mgriff2000/OmniAnt/README.md

# OmniAnt
Repo for the KiCad project for OmniAnt
