mgriff2000/OmniAnt/OmniAnt/report.txt

Info: Processing symbol 'AC1:Footprints:LIS3DHTR'.
Info: Processing symbol 'AC2:Footprints:LIS3DHTR'.
Info: Processing symbol 'C1:PCM_JLCPCB:C_0805'.
Info: Processing symbol 'C2:PCM_JLCPCB:C_0603'.
Info: Processing symbol 'C3:PCM_JLCPCB:C_0603'.
Info: Processing symbol 'C4:PCM_JLCPCB:C_0603'.
Info: Processing symbol 'C5:PCM_JLCPCB:C_0603'.
Info: Processing symbol 'C6:PCM_JLCPCB:C_0805'.
Info: Processing symbol 'C7:PCM_JLCPCB:C_0805'.
Info: Processing symbol 'C8:PCM_JLCPCB:C_0603'.
Info: Processing symbol 'C9:PCM_JLCPCB:C_0805'.
Info: Processing symbol 'C10:PCM_JLCPCB:C_0805'.
Info: Processing symbol 'C11:PCM_JLCPCB:C_0603'.
Info: Processing symbol 'C12:PCM_JLCPCB:C_0805'.
Info: Processing symbol 'C13:PCM_JLCPCB:C_0805'.
Info: Processing symbol 'C14:PCM_JLCPCB:C_0805'.
Info: Processing symbol 'C15:PCM_JLCPCB:C_0603'.
Info: Processing symbol 'C16:PCM_JLCPCB:C_0603'.
Info: Processing symbol 'C17:PCM_JLCPCB:C_0603'.
Info: Processing symbol 'C18:PCM_JLCPCB:C_0603'.
Info: Processing symbol 'C19:PCM_JLCPCB:C_0805'.
Info: Processing symbol 'C20:PCM_JLCPCB:C_0603'.
Info: Processing symbol 'C21:PCM_JLCPCB:C_0603'.
Info: Processing symbol 'C22:PCM_JLCPCB:C_0603'.
Info: Processing symbol 'C23:PCM_JLCPCB:C_0603'.
Info: Processing symbol 'C24:PCM_JLCPCB:C_0603'.
Info: Processing symbol 'C25:PCM_JLCPCB:C_0603'.
Info: Processing symbol 'C26:PCM_JLCPCB:C_0603'.
Info: Processing symbol 'C27:PCM_JLCPCB:C_0603'.
Info: Processing symbol 'C28:PCM_JLCPCB:C_0603'.
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
Change Q2 footprint from 'Footprints:NVMFS5C442NLWFAFT1G' to 'NVMFS5C442NLWFAFT1G'.
Change Q4 footprint from 'Footprints:NVMFS5C442NLWFAFT1G' to 'NVMFS5C442NLWFAFT1G'.
Change Q11 footprint from 'Footprints:NVMFS5C442NLWFAFT1G' to 'NVMFS5C442NLWFAFT1G'.

Warning: No net found for component J8 pad S2 (no pin S2 in symbol).
Warning: No net found for component J9 pad S1 (no pin S1 in symbol).
Warning: No net found for component J9 pad S2 (no pin S2 in symbol).
Warning: No net found for component U3 pad 44 (no pin 44 in symbol).
Warning: No net found for component U3 pad 41 (no pin 41 in symbol).
Warning: No net found for component U3 pad 45 (no pin 45 in symbol).
Warning: No net found for component U3 pad 39 (no pin 39 in symbol).
Warning: No net found for component U3 pad 42 (no pin 42 in symbol).
Warning: No net found for component U3 pad 38 (no pin 38 in symbol).
Warning: No net found for component J6 pad S1 (no pin S1 in symbol).
Warning: No net found for component U3 pad 43 (no pin 43 in symbol).
Warning: No net found for component J6 pad S2 (no pin S2 in symbol).
Warning: No net found for component J7 pad S1 (no pin S1 in symbol).
Warning: No net found for component U5 pad 45 (no pin 45 in symbol).
Warning: No net found for component U5 pad 44 (no pin 44 in symbol).
Warning: No net found for component U5 pad 41 (no pin 41 in symbol).
Warning: No net found for component U5 pad 39 (no pin 39 in symbol).
Warning: No net found for component U5 pad 42 (no pin 42 in symbol).
Warning: No net found for component U5 pad 38 (no pin 38 in symbol).
Warning: No net found for component U5 pad 43 (no pin 43 in symbol).
Warning: No net found for component U5 pad 40 (no pin 40 in symbol).
Warning: No net found for component J7 pad S2 (no pin S2 in symbol).
Warning: No net found for component J8 pad S1 (no pin S1 in symbol).
Warning: No net found for component U3 pad 40 (no pin 40 in symbol).

Info: Total warnings: 24, errors: 0.
