mgriff2000/OmniAnt/OmniAnt/OmniAnt.kicad_pcb

## KiCad design OmniAnt/OmniAnt.kicad_pcb (2025-11-13)

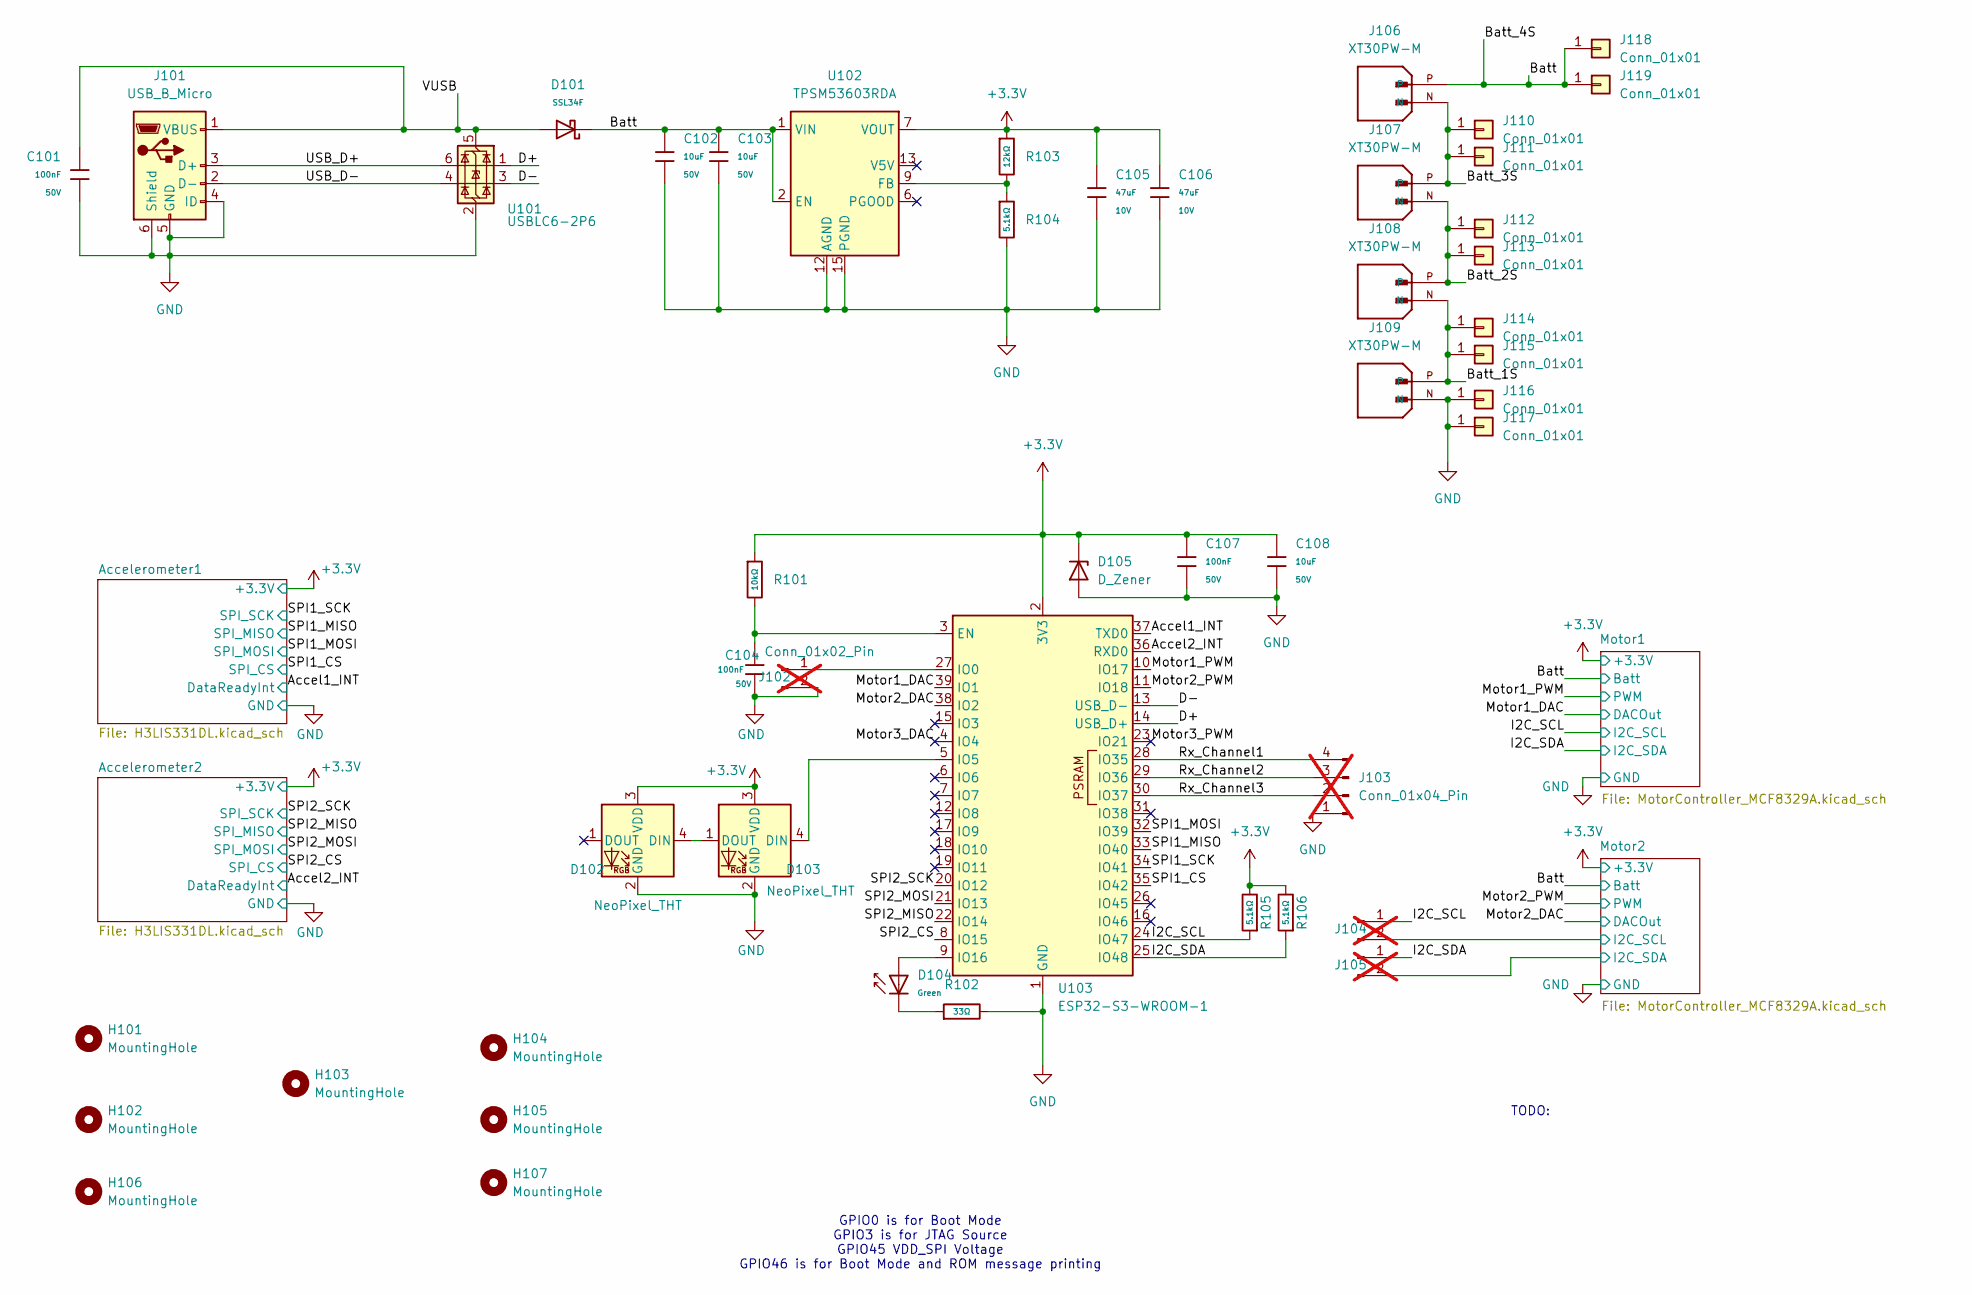
[picture p1: schematic OmniAnt.kicad_sch]

Parts:
C101, C104, C107: 100nF; C_0603; Voltage Rated 50V; Tolerance ±10%; Part CC0603KRX7R9BB104; LCSC C14663
C102, C103, C108: 10uF; C_0805; Voltage Rated 50V; Tolerance ±10%; Part GRM21BR61H106KE43L; LCSC C440198
C105, C106: 47uF; C_1206; Voltage Rated 10V; Tolerance ±20%; Part CL31A476MPHNNNE; LCSC C96123
D101: SSL34F; D_SMAF; Part SSL34F; LCSC C28646282
D102, D103: NeoPixel_THT; LED_D5.0mm-4_RGB
D104: Green; D_0805; Part KT-0805G; LCSC C2297
D105: D_Zener; D_SOD-123FL; Manufacturer Part Number SMF3.3; LCSC C2649858
H101, H102, H104, H105, H106, H107: MountingHole; MountingHole_3mm
H103: MountingHole; MountingHole_4.3mm_M4_DIN965
J101: USB_B_Micro; USB_Micro-B_Molex-105017-0001; LCSC C136000
J102, J104, J105: Conn_01x02_Pin; PinHeader_1x02_P1.27mm_Vertical; not fitted
J103: Conn_01x04_Pin; PinHeader_1x04_P2.54mm_Vertical; not fitted
J106, J107, J108, J109: XT30PW-M; AMASS_XT30PW-M; PARTREV 1.2; LCSC C431092
J110, J111, J112, J113, J114, J115, J116, J117, J118, J119: Conn_01x01; SolderWire-1.5sqmm_1x01_D1.7mm_OD3mm
R101: 10kΩ; R_0402; Overload Voltage (Max) 50V; Tolerance ±1%; Part 0402WGF1002TCE; LCSC C25744
R102: 33Ω; R_0402; Overload Voltage (Max) 50V; Tolerance ±1%; Part 0402WGF330JTCE; LCSC C25105
R103: 12kΩ; R_0402; Overload Voltage (Max) 50V; Tolerance ±1%; Part 0402WGF1202TCE; LCSC C25752
R104, R105, R106: 5.1kΩ; R_0402; Overload Voltage (Max) 50V; Tolerance ±1%; Part 0402WGF5101TCE; LCSC C25905
U101: USBLC6-2P6; SOT-666; LCSC C15999
U102: TPSM53603RDA; Texas_B3QFN-14-1EP_5x5.5mm_P0.65mm_ThermalVia; LCSC C2860943
U103: ESP32-S3-WROOM-1; LCSC C2913197

Connections:
+3.3V: C105.1, C106.1, C107.1, C108.1, D102.3 (VDD), D103.3 (VDD), D105.1 (K), R101.1, R103.1, R105.2, R106.2, U102.7 (VOUT), U102.8 (VOUT), U103.2 (3V3); also elsewhere on the board
/Accel1_INT: U103.37 (TXD0); also elsewhere on the board
/Accel2_INT: U103.36 (RXD0); also elsewhere on the board
/Batt: C102.1, C103.1, D101.1, J106.P, J118.1, J119.1, U102.1 (VIN), U102.2 (EN), U102.14 (VIN); also elsewhere on the board
/Batt_1S: J108.N, J109.P, J114.1, J115.1
/Batt_2S: J107.N, J108.P, J112.1, J113.1
/Batt_3S: J106.N, J107.P, J110.1, J111.1
/D+: U101.1 (I/O1), U103.14 (USB_D+)
/D-: U101.3 (I/O2), U103.13 (USB_D-)
/I2C_SCL: J104.1, R105.1, U103.24 (IO47); also elsewhere on the board
/I2C_SDA: J105.1, R106.1, U103.25 (IO48); also elsewhere on the board
/Motor1_DAC: U103.39 (IO1); also elsewhere on the board
/Motor1_PWM: U103.10 (IO17); also elsewhere on the board
/Motor2/I2C_SCL: J104.2; also elsewhere on the board
/Motor2/I2C_SDA: J105.2; also elsewhere on the board
/Motor2_DAC: U103.38 (IO2); also elsewhere on the board
/Motor2_PWM: U103.11 (IO18); also elsewhere on the board
/Motor3_DAC: U103.4 (IO4)
/Motor3_PWM: U103.23 (IO21)
/Rx_Channel1: J103.4, U103.28 (IO35)
/Rx_Channel2: J103.3, U103.29 (IO36)
/Rx_Channel3: J103.2, U103.30 (IO37)
/SPI1_CS: U103.35 (IO42); also elsewhere on the board
/SPI1_MISO: U103.33 (IO40); also elsewhere on the board
/SPI1_MOSI: U103.32 (IO39); also elsewhere on the board
/SPI1_SCK: U103.34 (IO41); also elsewhere on the board
/SPI2_CS: U103.8 (IO15); also elsewhere on the board
/SPI2_MISO: U103.22 (IO14); also elsewhere on the board
/SPI2_MOSI: U103.21 (IO13); also elsewhere on the board
/SPI2_SCK: U103.20 (IO12); also elsewhere on the board
/USB_D+: J101.3 (D+), U101.6 (I/O1)
/USB_D-: J101.2 (D-), U101.4 (I/O2)
/VUSB: C101.1, D101.2, J101.1 (VBUS), U101.5 (VBUS)
GND: C101.2, C102.2, C103.2, C104.2, C105.2, C106.2, C107.2, C108.2, D102.2 (GND), D103.2 (GND), D105.2 (A), J101.4 (ID), J101.5 (GND), J101.6 (Shield), J102.2, J103.1, J109.N, J116.1, J117.1, R102.2, R104.2, U101.2 (GND), U102.3 (PGND), U102.10 (PGND), U102.11 (PGND), U102.12 (AGND), U102.15 (PGND), U103.1 (GND), U103.40 (GND), U103.41 (GND); also elsewhere on the board
unnamed: D102.4 (DIN), D103.1 (DOUT)
unnamed: D103.4 (DIN), U103.5 (IO5)
unnamed: D104.1, R102.1
unnamed: J102.1, U103.27 (IO0)
unnamed: R103.2, R104.1, U102.9 (FB)
unnamed: C104.1, R101.2, U103.3 (EN)
unnamed: D104.2, U103.9 (IO16)

Notes on the sheet:
TODO:
GPIO0 is for Boot Mode GPIO3 is for JTAG Source GPIO45 VDD_SPI Voltage GPIO46 is for Boot Mode and ROM message printing

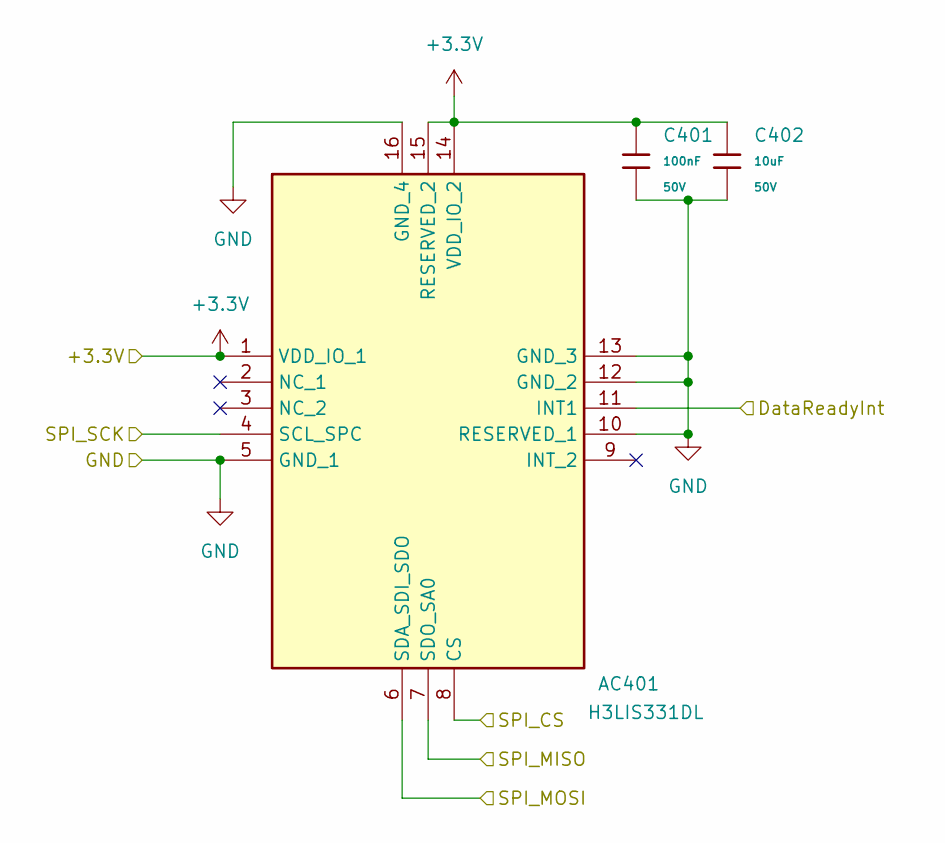
[picture p2: schematic H3LIS331DL.kicad_sch]

Parts:
AC401: H3LIS331DL; LIS3DHTR; Manufacturer_Part_Number H3LIS331DL; Mouser Part Number 511-H3LIS331DL
C401: 100nF; C_0603; Voltage Rated 50V; Tolerance ±10%; Part CC0603KRX7R9BB104; LCSC C14663
C402: 10uF; C_0805; Voltage Rated 50V; Tolerance ±10%; Part GRM21BR61H106KE43L; LCSC C440198

Connections:
+3.3V: AC401.1 (VDD_IO_1), AC401.14 (VDD_IO_2), AC401.15 (RESERVED_2), C401.1, C402.1; also elsewhere on the board
/Accel1_INT: AC401.11 (INT1); also elsewhere on the board
/SPI1_CS: AC401.8 (CS); also elsewhere on the board
/SPI1_MISO: AC401.7 (SDO_SA0); also elsewhere on the board
/SPI1_MOSI: AC401.6 (SDA_SDI_SDO); also elsewhere on the board
/SPI1_SCK: AC401.4 (SCL_SPC); also elsewhere on the board
GND: AC401.5 (GND_1), AC401.10 (RESERVED_1), AC401.12 (GND_2), AC401.13 (GND_3), AC401.16 (GND_4), C401.2, C402.2; also elsewhere on the board

Parts of its further copies:
AC501: H3LIS331DL; LIS3DHTR; Manufacturer_Part_Number H3LIS331DL; Mouser Part Number 511-H3LIS331DL
C501: 100nF; C_0603; Voltage Rated 50V; Tolerance ±10%; Part CC0603KRX7R9BB104; LCSC C14663
C502: 10uF; C_0805; Voltage Rated 50V; Tolerance ±10%; Part GRM21BR61H106KE43L; LCSC C440198

Connections of its further copies:
+3.3V: AC501.1 (VDD_IO_1), AC501.14 (VDD_IO_2), AC501.15 (RESERVED_2), C501.1, C502.1; also elsewhere on the board
/Accel2_INT: AC501.11 (INT1); also elsewhere on the board
/SPI2_CS: AC501.8 (CS); also elsewhere on the board
/SPI2_MISO: AC501.7 (SDO_SA0); also elsewhere on the board
/SPI2_MOSI: AC501.6 (SDA_SDI_SDO); also elsewhere on the board
/SPI2_SCK: AC501.4 (SCL_SPC); also elsewhere on the board
GND: AC501.5 (GND_1), AC501.10 (RESERVED_1), AC501.12 (GND_2), AC501.13 (GND_3), AC501.16 (GND_4), C501.2, C502.2; also elsewhere on the board

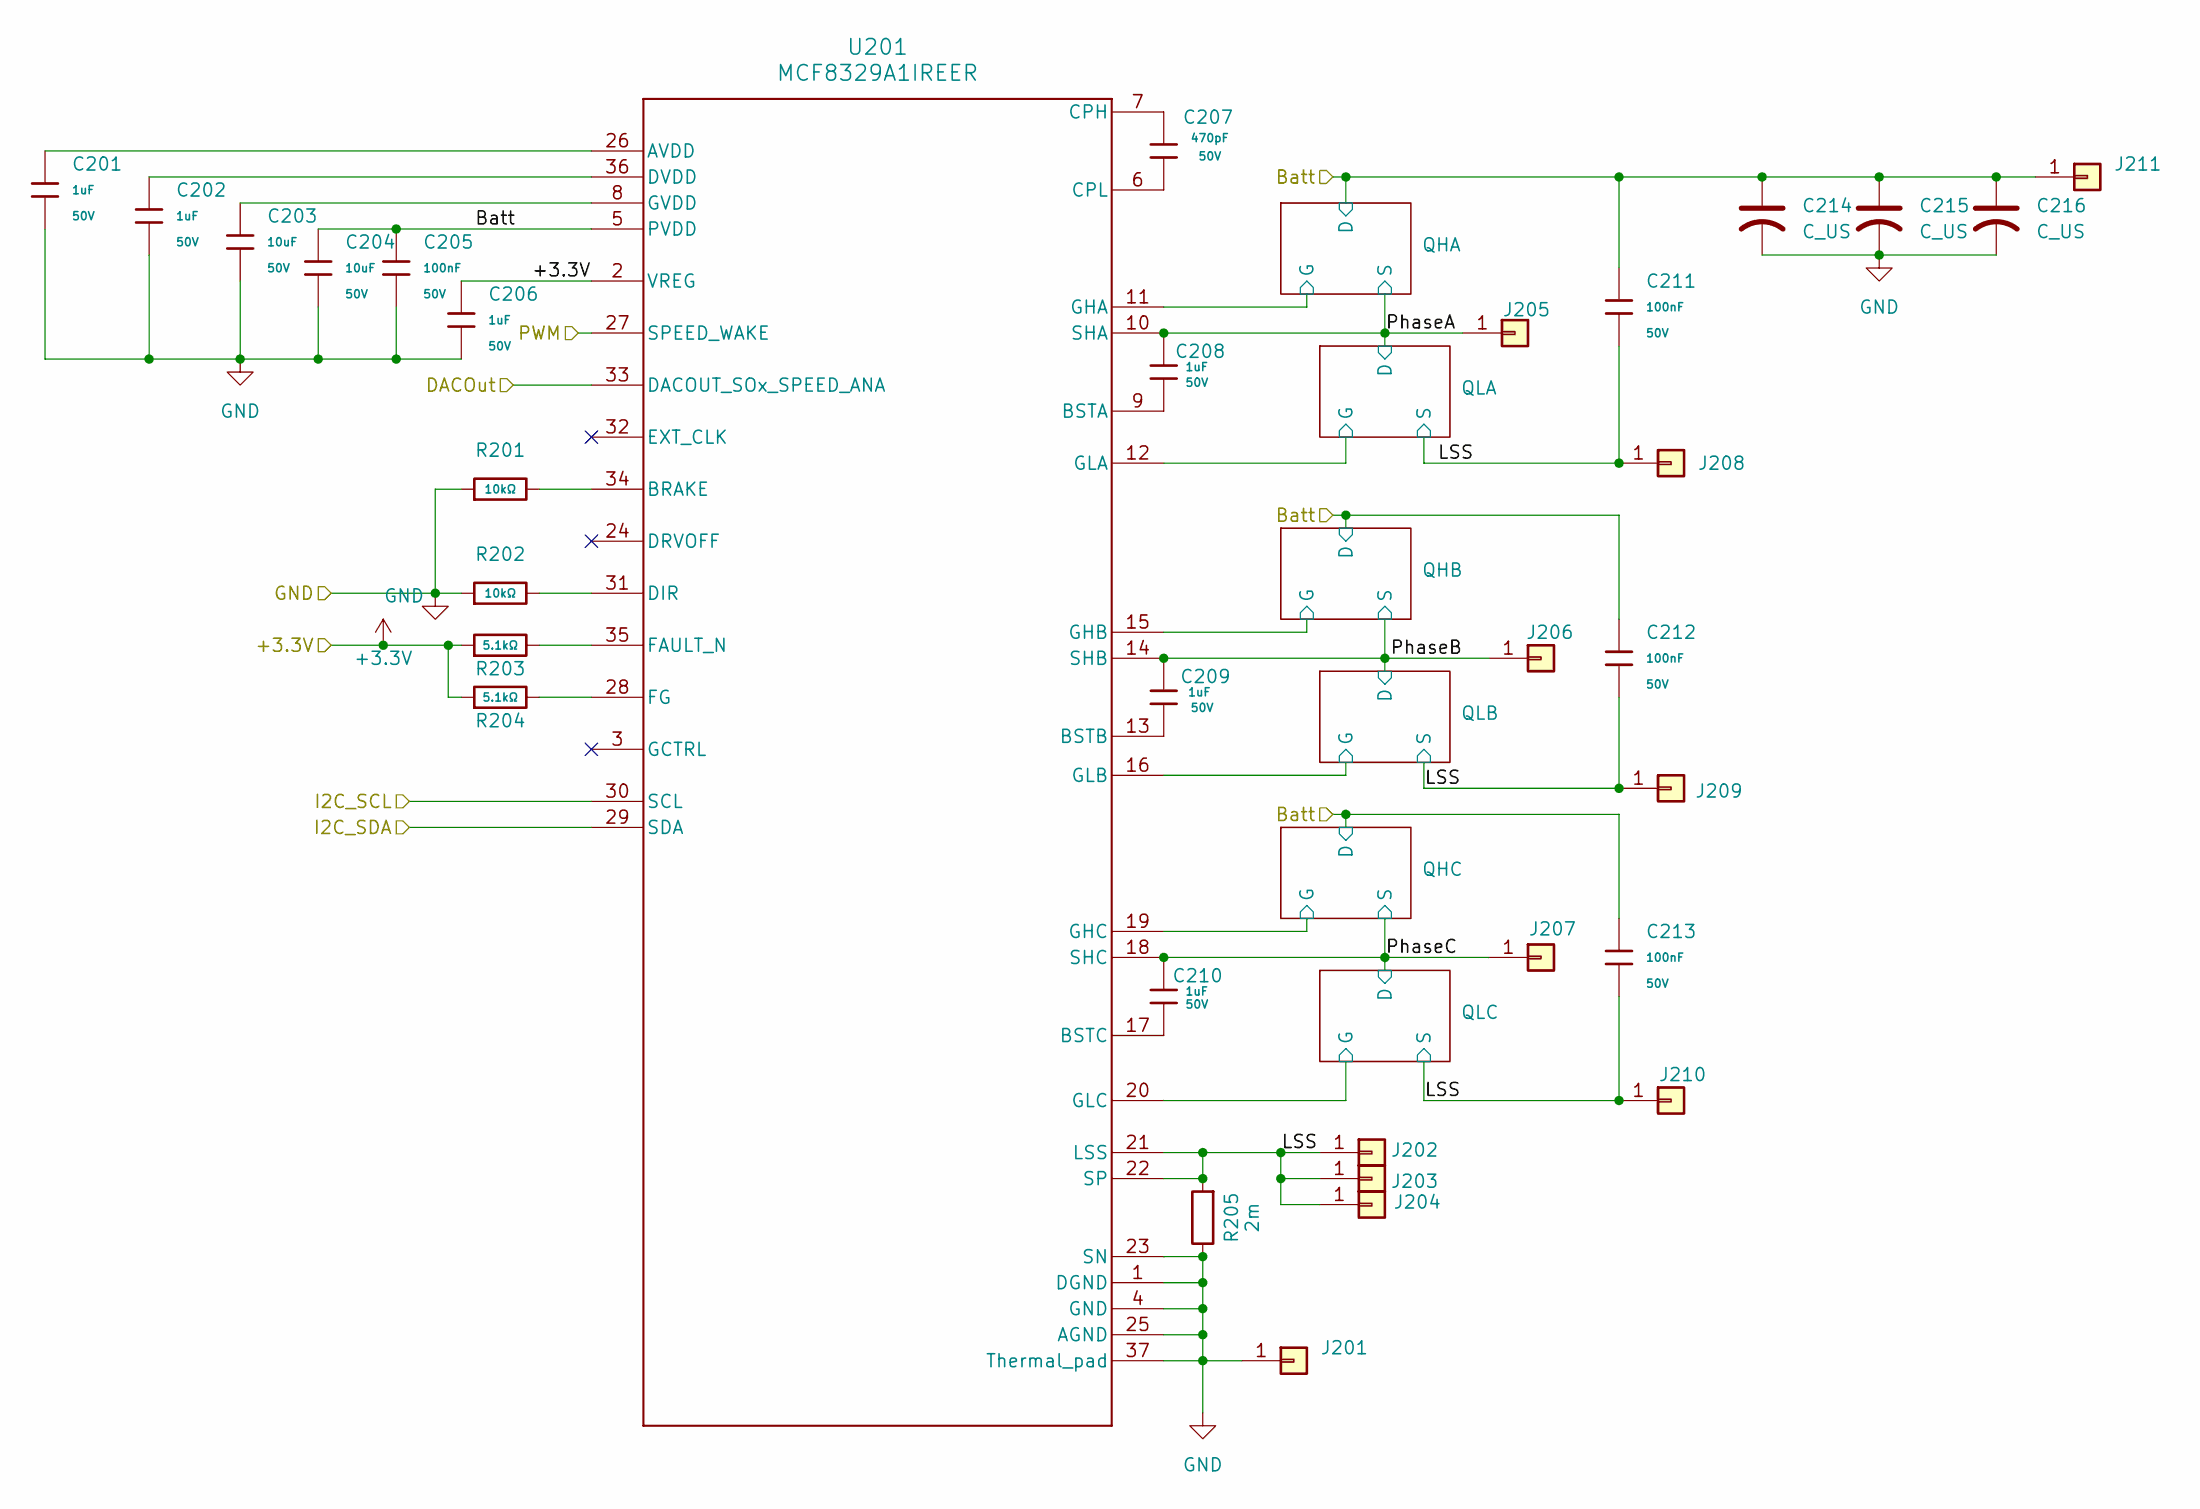
[picture p3: schematic MotorController_MCF8329A.kicad_sch]

Parts:
C201, C202, C206, C208, C209, C210: 1uF; C_0603; Voltage Rated 50V; Tolerance ±10%; Part CL10A105KB8NNNC; LCSC C15849
C203, C204: 10uF; C_0805; Voltage Rated 50V; Tolerance ±10%; Part GRM21BR61H106KE43L; LCSC C440198
C205, C211, C212, C213: 100nF; C_0603; Voltage Rated 50V; Tolerance ±10%; Part CC0603KRX7R9BB104; LCSC C14663
C207: 470pF; C_0603; Voltage Rated 50V; Tolerance ±10%; Part 0603B471K500NT; LCSC C1620
C214: C_US; CP_Radial_D6.3mm_P2.50mm; Manufacturer Part Number HT1E227M0607PC
C215, C216: C_US; CP_Radial_D6.3mm_P2.50mm
J201, J211: Conn_01x01; SolderWire-1.5sqmm_1x01_D1.7mm_OD3mm
J202, J203, J204, J205, J206, J207, J208, J209, J210: Conn_01x01; SolderWire-0.25sqmm_1x01_D0.65mm_OD1.7mm
R201, R202: 10kΩ; R_0402; Overload Voltage (Max) 50V; Tolerance ±1%; Part 0402WGF1002TCE; LCSC C25744
R203, R204: 5.1kΩ; R_0402; Overload Voltage (Max) 50V; Tolerance ±1%; Part 0402WGF5101TCE; LCSC C25905
R205: 2m; R_1206_3216Metric
U201: MCF8329A1IREER; REE0036A-MFG

Connections:
+3.3V: C206.1, R203.1, R204.1, U201.2 (VREG); also elsewhere on the board
/Batt: C204.1, C205.1, C211.1, C212.1, C213.1, C214.1, C215.1, C216.1, J211.1, U201.5 (PVDD); also elsewhere on the board
/I2C_SCL: U201.30 (SCL); also elsewhere on the board
/I2C_SDA: U201.29 (SDA); also elsewhere on the board
/Motor1/LSS: C211.2, C212.2, C213.2, J202.1, J203.1, J204.1, J208.1, J209.1, J210.1, R205.2, U201.21 (LSS), U201.22 (SP); also elsewhere on the board
/Motor1/PhaseA: C208.1, J205.1, U201.10 (SHA); also elsewhere on the board
/Motor1/PhaseB: C209.1, J206.1, U201.14 (SHB); also elsewhere on the board
/Motor1/PhaseC: C210.1, J207.1, U201.18 (SHC); also elsewhere on the board
/Motor1/QHA/G: U201.11 (GHA); also elsewhere on the board
/Motor1/QHB/G: U201.15 (GHB); also elsewhere on the board
/Motor1/QHC/G: U201.19 (GHC); also elsewhere on the board
/Motor1/QLA/G: U201.12 (GLA); also elsewhere on the board
/Motor1/QLB/G: U201.16 (GLB); also elsewhere on the board
/Motor1/QLC/G: U201.20 (GLC); also elsewhere on the board
/Motor1_DAC: U201.33 (DACOUT_SOx_SPEED_ANA); also elsewhere on the board
/Motor1_PWM: U201.27 (SPEED_WAKE); also elsewhere on the board
GND: C201.2, C202.2, C203.2, C204.2, C205.2, C206.2, C214.2, C215.2, C216.2, J201.1, R201.1, R202.1, R205.1, U201.1 (DGND), U201.4 (GND), U201.23 (SN), U201.25 (AGND), U201.37 (Thermal_pad), U201.38, U201.39, U201.40, U201.41, U201.42, U201.43, U201.44, U201.45; also elsewhere on the board
unnamed: C201.1, U201.26 (AVDD)
unnamed: R201.2, U201.34 (BRAKE)
unnamed: C208.2, U201.9 (BSTA)
unnamed: C209.2, U201.13 (BSTB)
unnamed: C210.2, U201.17 (BSTC)
unnamed: C207.1, U201.7 (CPH)
unnamed: C207.2, U201.6 (CPL)
unnamed: R202.2, U201.31 (DIR)
unnamed: C202.1, U201.36 (DVDD)
unnamed: R203.2, U201.35 (FAULT_N)
unnamed: R204.2, U201.28 (FG)
unnamed: C203.1, U201.8 (GVDD)

Parts of its further copies:
C301, C302, C306, C308, C309, C310: 1uF; C_0603; Voltage Rated 50V; Tolerance ±10%; Part CL10A105KB8NNNC; LCSC C15849
C303, C304: 10uF; C_0805; Voltage Rated 50V; Tolerance ±10%; Part GRM21BR61H106KE43L; LCSC C440198
C305, C311, C312, C313: 100nF; C_0603; Voltage Rated 50V; Tolerance ±10%; Part CC0603KRX7R9BB104; LCSC C14663
C307: 470pF; C_0603; Voltage Rated 50V; Tolerance ±10%; Part 0603B471K500NT; LCSC C1620
C314: C_US; CP_Radial_D6.3mm_P2.50mm; Manufacturer Part Number HT1E227M0607PC
C315, C316: C_US; CP_Radial_D6.3mm_P2.50mm
J301, J311: Conn_01x01; SolderWire-1.5sqmm_1x01_D1.7mm_OD3mm
J302, J303, J304, J305, J306, J307, J308, J309, J310: Conn_01x01; SolderWire-0.25sqmm_1x01_D0.65mm_OD1.7mm
R301, R302: 10kΩ; R_0402; Overload Voltage (Max) 50V; Tolerance ±1%; Part 0402WGF1002TCE; LCSC C25744
R303, R304: 5.1kΩ; R_0402; Overload Voltage (Max) 50V; Tolerance ±1%; Part 0402WGF5101TCE; LCSC C25905
R305: 2m; R_1206_3216Metric
U301: MCF8329A1IREER; REE0036A-MFG

Connections of its further copies:
+3.3V: C306.1, R303.1, R304.1, U301.2 (VREG); also elsewhere on the board
/Batt: C304.1, C305.1, C311.1, C312.1, C313.1, C314.1, C315.1, C316.1, J311.1, U301.5 (PVDD); also elsewhere on the board
/Motor2/I2C_SCL: U301.30 (SCL); also elsewhere on the board
/Motor2/I2C_SDA: U301.29 (SDA); also elsewhere on the board
/Motor2/LSS: C311.2, C312.2, C313.2, J302.1, J303.1, J304.1, J308.1, J309.1, J310.1, R305.2, U301.21 (LSS), U301.22 (SP); also elsewhere on the board
/Motor2/PhaseA: C308.1, J305.1, U301.10 (SHA); also elsewhere on the board
/Motor2/PhaseB: C309.1, J306.1, U301.14 (SHB); also elsewhere on the board
/Motor2/PhaseC: C310.1, J307.1, U301.18 (SHC); also elsewhere on the board
/Motor2/QHA/G: U301.11 (GHA); also elsewhere on the board
/Motor2/QHB/G: U301.15 (GHB); also elsewhere on the board
/Motor2/QHC/G: U301.19 (GHC); also elsewhere on the board
/Motor2/QLA/G: U301.12 (GLA); also elsewhere on the board
/Motor2/QLB/G: U301.16 (GLB); also elsewhere on the board
/Motor2/QLC/G: U301.20 (GLC); also elsewhere on the board
/Motor2_DAC: U301.33 (DACOUT_SOx_SPEED_ANA); also elsewhere on the board
/Motor2_PWM: U301.27 (SPEED_WAKE); also elsewhere on the board
GND: C301.2, C302.2, C303.2, C304.2, C305.2, C306.2, C314.2, C315.2, C316.2, J301.1, R301.1, R302.1, R305.1, U301.1 (DGND), U301.4 (GND), U301.23 (SN), U301.25 (AGND), U301.37 (Thermal_pad), U301.38, U301.39, U301.40, U301.41, U301.42, U301.43, U301.44, U301.45; also elsewhere on the board
unnamed: C301.1, U301.26 (AVDD)
unnamed: R301.2, U301.34 (BRAKE)
unnamed: C308.2, U301.9 (BSTA)
unnamed: C309.2, U301.13 (BSTB)
unnamed: C310.2, U301.17 (BSTC)
unnamed: C307.1, U301.7 (CPH)
unnamed: C307.2, U301.6 (CPL)
unnamed: R302.2, U301.31 (DIR)
unnamed: C302.1, U301.36 (DVDD)
unnamed: R303.2, U301.35 (FAULT_N)
unnamed: R304.2, U301.28 (FG)
unnamed: C303.1, U301.8 (GVDD)

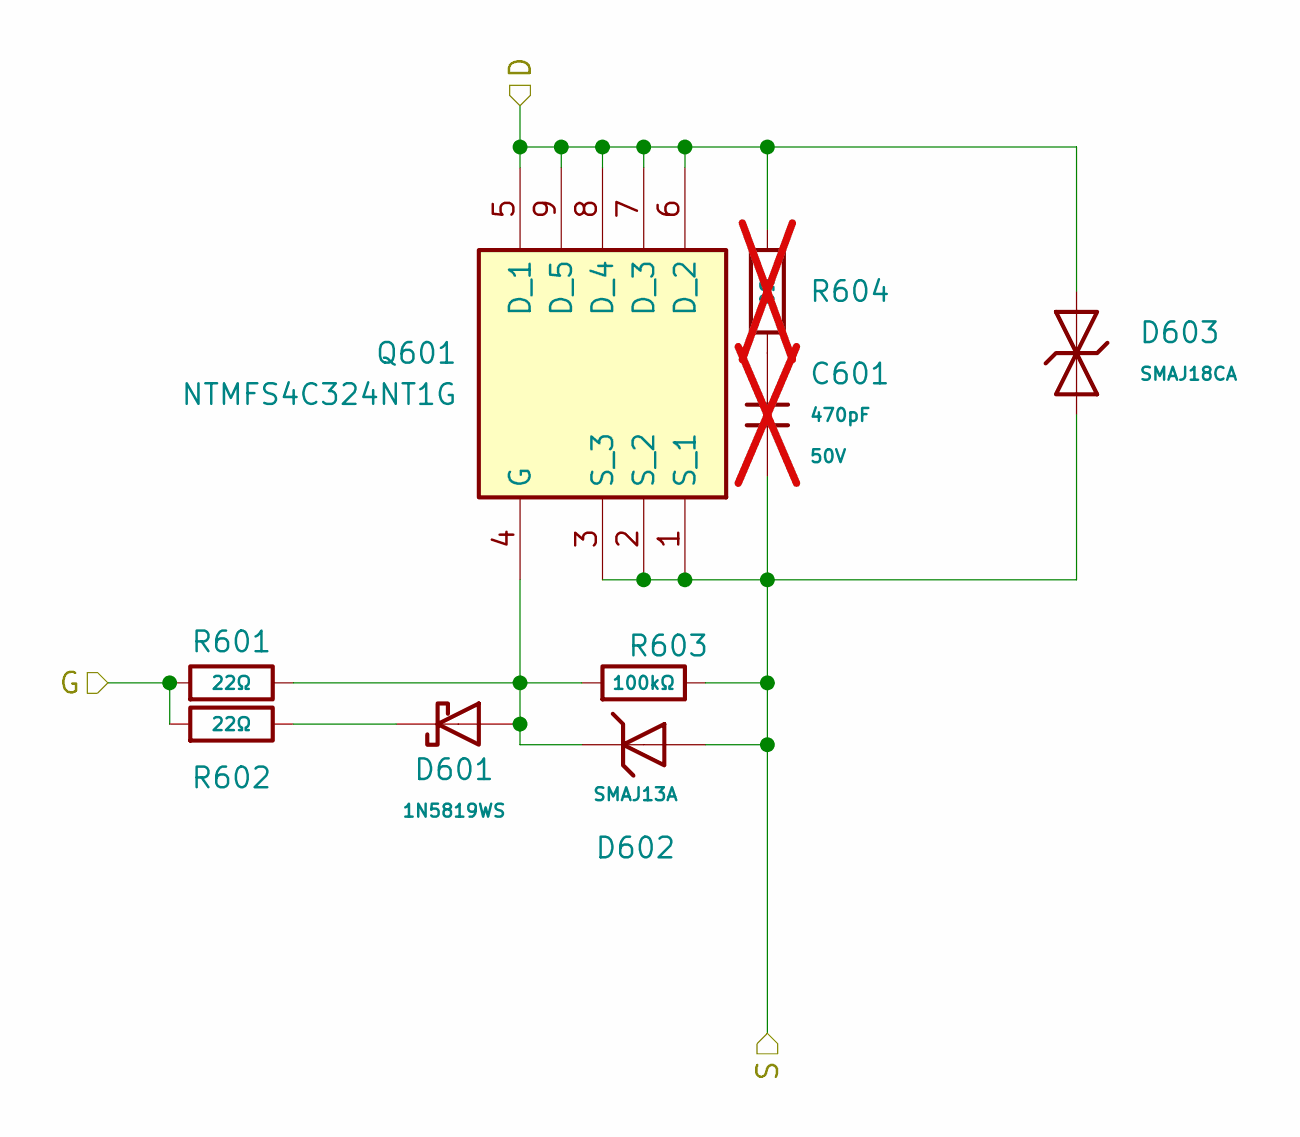
[picture p4: schematic MOSFET_WithExternalCircuits.kicad_sch]

Parts:
C601: 470pF; C_0603; Voltage Rated 50V; Tolerance ±10%; Part 0603B471K500NT; LCSC C1620; not fitted
D601: 1N5819WS; D_SOD-323; Forward Voltage (Vf@If) 600mV@1A; Reverse Voltage (Vr) 40V; Part 1N5819WS; LCSC C191023
D602: SMAJ13A; D_SMA; Part SMAJ13A; LCSC C19077533
D603: SMAJ18CA; D_SMA; Part SMAJ18CA; LCSC C19077539
Q601: NTMFS4C324NT1G; NVMFS5C442NLWFAFT1G; Mouser Part Number 863-NTMFS4C324NT1G
R601, R602: 22Ω; R_0805; Overload Voltage (Max) 150V; Tolerance ±1%; Part 0805W8F220JT5E; LCSC C17561
R603: 100kΩ; R_0402; Overload Voltage (Max) 50V; Tolerance ±1%; Part 0402WGF1003TCE; LCSC C25741
R604: 0Ω; R_0603; Overload Voltage (Max) 75V; Tolerance ±1%; Part 0603WAF0000T5E; LCSC C21189; not fitted

Connections:
/Motor1/LSS: C601.2, D602.2, D603.1, Q601.1 (S_1), Q601.2 (S_2), Q601.3 (S_3), R603.2; also elsewhere on the board
/Motor1/PhaseA: D603.2, Q601.5 (D_1), Q601.6 (D_2), Q601.7 (D_3), Q601.8 (D_4), Q601.9 (D_5), R604.1; also elsewhere on the board
/Motor1/QLA/G: R601.1, R602.1; also elsewhere on the board
unnamed: C601.1, R604.2
unnamed: D601.1, R602.2
unnamed: D601.2, D602.1, Q601.4 (G), R601.2, R603.1

Parts of its further copies:
C701, C801, C901, C1001, C1101, C1201, C1301, C1401, C1501, C1601, C1701: 470pF; C_0603; Voltage Rated 50V; Tolerance ±10%; Part 0603B471K500NT; LCSC C1620; not fitted
D701, D801, D901, D1001, D1101, D1201, D1301, D1401, D1501, D1601, D1701: 1N5819WS; D_SOD-323; Forward Voltage (Vf@If) 600mV@1A; Reverse Voltage (Vr) 40V; Part 1N5819WS; LCSC C191023
D702, D802, D902, D1002, D1102, D1202, D1302, D1402, D1502, D1602, D1702: SMAJ13A; D_SMA; Part SMAJ13A; LCSC C19077533
D703, D803, D903, D1003, D1103, D1203, D1303, D1403, D1503, D1603, D1703: SMAJ18CA; D_SMA; Part SMAJ18CA; LCSC C19077539
Q701, Q801, Q901, Q1001, Q1101, Q1201, Q1301, Q1401, Q1501, Q1601, Q1701: NTMFS4C324NT1G; NVMFS5C442NLWFAFT1G; Mouser Part Number 863-NTMFS4C324NT1G
R701, R702, R801, R802, R901, R902, R1001, R1002, R1101, R1102, R1201, R1202, R1301, R1302, R1401, R1402, R1501, R1502, R1601, R1602, R1701, R1702: 22Ω; R_0805; Overload Voltage (Max) 150V; Tolerance ±1%; Part 0805W8F220JT5E; LCSC C17561
R703, R803, R903, R1003, R1103, R1203, R1303, R1403, R1503, R1603, R1703: 100kΩ; R_0402; Overload Voltage (Max) 50V; Tolerance ±1%; Part 0402WGF1003TCE; LCSC C25741
R704, R804, R904, R1004, R1104, R1204, R1304, R1404, R1504, R1604, R1704: 0Ω; R_0603; Overload Voltage (Max) 75V; Tolerance ±1%; Part 0603WAF0000T5E; LCSC C21189; not fitted

Connections of its further copies:
/Batt: D703.2, D803.2, D1003.2, D1203.2, D1403.2, D1603.2, Q701.5 (D_1), Q701.6 (D_2), Q701.7 (D_3), Q701.8 (D_4), Q701.9 (D_5), Q801.5 (D_1), Q801.6 (D_2), Q801.7 (D_3), Q801.8 (D_4), Q801.9 (D_5), Q1001.5 (D_1), Q1001.6 (D_2), Q1001.7 (D_3), Q1001.8 (D_4), Q1001.9 (D_5), Q1201.5 (D_1), Q1201.6 (D_2), Q1201.7 (D_3), Q1201.8 (D_4), Q1201.9 (D_5), Q1401.5 (D_1), Q1401.6 (D_2), Q1401.7 (D_3), Q1401.8 (D_4), Q1401.9 (D_5), Q1601.5 (D_1), Q1601.6 (D_2), Q1601.7 (D_3), Q1601.8 (D_4), Q1601.9 (D_5), R704.1, R804.1, R1004.1, R1204.1, R1404.1, R1604.1; also elsewhere on the board
/Motor1/LSS: C901.2, C1301.2, D902.2, D903.1, D1302.2, D1303.1, Q901.1 (S_1), Q901.2 (S_2), Q901.3 (S_3), Q1301.1 (S_1), Q1301.2 (S_2), Q1301.3 (S_3), R903.2, R1303.2; also elsewhere on the board
/Motor1/PhaseA: C701.2, D702.2, D703.1, Q701.1 (S_1), Q701.2 (S_2), Q701.3 (S_3), R703.2; also elsewhere on the board
/Motor1/PhaseB: C1001.2, D903.2, D1002.2, D1003.1, Q901.5 (D_1), Q901.6 (D_2), Q901.7 (D_3), Q901.8 (D_4), Q901.9 (D_5), Q1001.1 (S_1), Q1001.2 (S_2), Q1001.3 (S_3), R904.1, R1003.2; also elsewhere on the board
/Motor1/PhaseC: C1401.2, D1303.2, D1402.2, D1403.1, Q1301.5 (D_1), Q1301.6 (D_2), Q1301.7 (D_3), Q1301.8 (D_4), Q1301.9 (D_5), Q1401.1 (S_1), Q1401.2 (S_2), Q1401.3 (S_3), R1304.1, R1403.2; also elsewhere on the board
/Motor1/QHA/G: R701.1, R702.1; also elsewhere on the board
/Motor1/QHB/G: R1001.1, R1002.1; also elsewhere on the board
/Motor1/QHC/G: R1401.1, R1402.1; also elsewhere on the board
/Motor1/QLB/G: R901.1, R902.1; also elsewhere on the board
/Motor1/QLC/G: R1301.1, R1302.1; also elsewhere on the board
/Motor2/LSS: C1101.2, C1501.2, C1701.2, D1102.2, D1103.1, D1502.2, D1503.1, D1702.2, D1703.1, Q1101.1 (S_1), Q1101.2 (S_2), Q1101.3 (S_3), Q1501.1 (S_1), Q1501.2 (S_2), Q1501.3 (S_3), Q1701.1 (S_1), Q1701.2 (S_2), Q1701.3 (S_3), R1103.2, R1503.2, R1703.2; also elsewhere on the board
/Motor2/PhaseA: C801.2, D802.2, D803.1, D1703.2, Q801.1 (S_1), Q801.2 (S_2), Q801.3 (S_3), Q1701.5 (D_1), Q1701.6 (D_2), Q1701.7 (D_3), Q1701.8 (D_4), Q1701.9 (D_5), R803.2, R1704.1; also elsewhere on the board
/Motor2/PhaseB: C1201.2, D1103.2, D1202.2, D1203.1, Q1101.5 (D_1), Q1101.6 (D_2), Q1101.7 (D_3), Q1101.8 (D_4), Q1101.9 (D_5), Q1201.1 (S_1), Q1201.2 (S_2), Q1201.3 (S_3), R1104.1, R1203.2; also elsewhere on the board
/Motor2/PhaseC: C1601.2, D1503.2, D1602.2, D1603.1, Q1501.5 (D_1), Q1501.6 (D_2), Q1501.7 (D_3), Q1501.8 (D_4), Q1501.9 (D_5), Q1601.1 (S_1), Q1601.2 (S_2), Q1601.3 (S_3), R1504.1, R1603.2; also elsewhere on the board
/Motor2/QHA/G: R801.1, R802.1; also elsewhere on the board
/Motor2/QHB/G: R1201.1, R1202.1; also elsewhere on the board
/Motor2/QHC/G: R1601.1, R1602.1; also elsewhere on the board
/Motor2/QLA/G: R1701.1, R1702.1; also elsewhere on the board
/Motor2/QLB/G: R1101.1, R1102.1; also elsewhere on the board
/Motor2/QLC/G: R1501.1, R1502.1; also elsewhere on the board
unnamed: C701.1, R704.2
unnamed: C801.1, R804.2
unnamed: C901.1, R904.2
unnamed: C1001.1, R1004.2
unnamed: C1101.1, R1104.2
unnamed: C1201.1, R1204.2
unnamed: C1301.1, R1304.2
unnamed: C1401.1, R1404.2
unnamed: C1501.1, R1504.2
unnamed: C1601.1, R1604.2
unnamed: C1701.1, R1704.2
unnamed: D701.1, R702.2
unnamed: D801.1, R802.2
unnamed: D901.1, R902.2
unnamed: D1001.1, R1002.2
unnamed: D1101.1, R1102.2
unnamed: D1201.1, R1202.2
unnamed: D1301.1, R1302.2
unnamed: D1401.1, R1402.2
unnamed: D1501.1, R1502.2
unnamed: D1601.1, R1602.2
unnamed: D1701.1, R1702.2
unnamed: D701.2, D702.1, Q701.4 (G), R701.2, R703.1
unnamed: D801.2, D802.1, Q801.4 (G), R801.2, R803.1
unnamed: D901.2, D902.1, Q901.4 (G), R901.2, R903.1
unnamed: D1001.2, D1002.1, Q1001.4 (G), R1001.2, R1003.1
unnamed: D1101.2, D1102.1, Q1101.4 (G), R1101.2, R1103.1
unnamed: D1201.2, D1202.1, Q1201.4 (G), R1201.2, R1203.1
unnamed: D1301.2, D1302.1, Q1301.4 (G), R1301.2, R1303.1
unnamed: D1401.2, D1402.1, Q1401.4 (G), R1401.2, R1403.1
unnamed: D1501.2, D1502.1, Q1501.4 (G), R1501.2, R1503.1
unnamed: D1601.2, D1602.1, Q1601.4 (G), R1601.2, R1603.1
unnamed: D1701.2, D1702.1, Q1701.4 (G), R1701.2, R1703.1

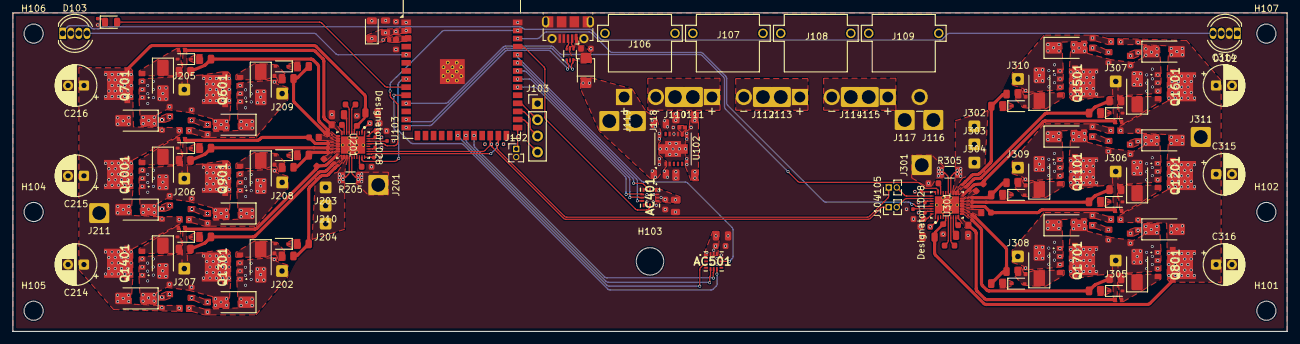
[picture p5: board OmniAnt.kicad_pcb from above]

Board: 4 copper layers, 200.0 x 50.0 mm, 228 parts (0 on the bottom side), 119 nets.
