mgriff2000/OmniAnt/(commit log)

2025-05-24 First Test Commit
    [OmniAnt.kicad_pcb, OmniAnt.kicad_sch]
2025-05-24 First commit through KiCad
    [OmniAnt.kicad_sch]
2025-05-27 I dropped in the esp, DCDC, diode, and usb connector.
    [OmniAnt.kicad_pcb, OmniAnt.kicad_sch]
2025-06-10 Added a schematic for the motor controller.
    [MotorController_MCF8329A.kicad_sch, OmniAnt.kicad_sch]
2025-06-13 Mostly organizing
    [MotorController_MCF8329A.kicad_sch, OmniAnt.kicad_pcb, OmniAnt.kicad_sch]
2025-06-13 Good progress on the power stage today.
    [MotorController_MCF8329A.kicad_sch, OmniAnt.kicad_pcb, OmniAnt.kicad_sch]
2025-06-16 I added a green LED.
    [MotorController_MCF8329A.kicad_sch, OmniAnt.kicad_pcb, OmniAnt.kicad_sch]
2025-06-16 I added in addressable LEDs, the accelerometers, and some inputs from a receiver just in case.
    [H3LIS331DL.kicad_sch, MotorController_MCF8329A.kicad_sch, OmniAnt.kicad_sch]
2025-06-27 I added in the XT30 Connectors for the batteries
    [H3LIS331DL.kicad_sch, MotorController_MCF8329A.kicad_sch, OmniAnt.kicad_pcb, OmniAnt.kicad_sch]
2025-07-01 added a link to the motor controller datasheet and changed the connector footprint for the RC interface.
    [MotorController_MCF8329A.kicad_sch, OmniAnt.kicad_pcb, OmniAnt.kicad_sch]
2025-07-07 fixed all the schematic errors.
    [H3LIS331DL.kicad_sch, MotorController_MCF8329A.kicad_sch, OmniAnt.kicad_pcb, OmniAnt.kicad_sch]
2025-07-11 I started to work on the rough placement.
    [MotorController_MCF8329A.kicad_sch, OmniAnt.kicad_pcb]
2025-07-16 Major progress on the motor driver layout. Lots of learning with how to draw traces and pours.
    [MotorController_MCF8329A.kicad_sch, OmniAnt.kicad_pcb, OmniAnt.kicad_sch]
2025-07-17 I made more progress on the layout. I'm working on adding the extra protection components to the driver circuit.
    [MotorController_MCF8329A.kicad_sch, OmniAnt.kicad_pcb, OmniAnt.kicad_sch]
2025-07-18 Ok I did a lot of reading today. I'm going to split each FET into a sheet, so I can add the external circuitry more easily.
    I may need to source a different FET. The one I selected has a good EAS, but the rating is only for 11A. and Ideally I would be able to do 19 or 20A. I'm sure I will never do that much current , but relying on the mosfet to handle things seems better than adding an additional tvs diode. Snubber is the way to go for sure to keep things cool.
    [MOSFET_WithExternalCircuits.kicad_sch, MotorController_MCF8329A.kicad_sch, OmniAnt.kicad_pcb, OmniAnt.kicad_sch]
2025-07-20 I got the mosfets in as a separate sheet and selected the additional protection circuitry. I'm working on finding the other recommended capacitors now.
    [MOSFET_WithExternalCircuits.kicad_sch, MotorController_MCF8329A.kicad_sch, OmniAnt.kicad_sch]
2025-07-21 Well shit making the FETs into libraries totally screwed up the annotation :( I decided to just redo the layout for the FETs anyhow.
    [H3LIS331DL.kicad_sch, MOSFET_WithExternalCircuits.kicad_sch, MotorController_MCF8329A.kicad_sch, OmniAnt.kicad_pcb, OmniAnt.kicad_sch]
2025-07-23 Really good progress today. I got all the FETs placed again and routed. I'm working on the pours for the FETs now.
    [MOSFET_WithExternalCircuits.kicad_sch, OmniAnt.kicad_pcb, OmniAnt.kicad_sch]
2025-08-01 I di some good work breaking out the traces around the gate driver. Unfortunatly when I went to connect the driver upto the FET array I noticed that I needed to reorder where the phase came out. To d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
    [MOSFET_WithExternalCircuits.kicad_sch, OmniAnt.kicad_pcb, OmniAnt.kicad_sch]
2025-08-12 Really good progress. I positioned everything, and ran a bunch of signals.
    [MOSFET_WithExternalCircuits.kicad_sch, OmniAnt.kicad_pcb, OmniAnt.kicad_sch]
2025-10-02 Everything looks good to me. I'm going to run design checks now. I'm sure it is going to be bad.
    [OmniAnt.kicad_pcb, OmniAnt.kicad_sch]
2025-11-13 Last Commit At eMatrix.
    [OmniAnt.kicad_pcb, OmniAnt.kicad_sch]
